constructiverealities/ProjectNorthStar/Mechanical/North Star 3D Files/components/leap-motion-classic.step

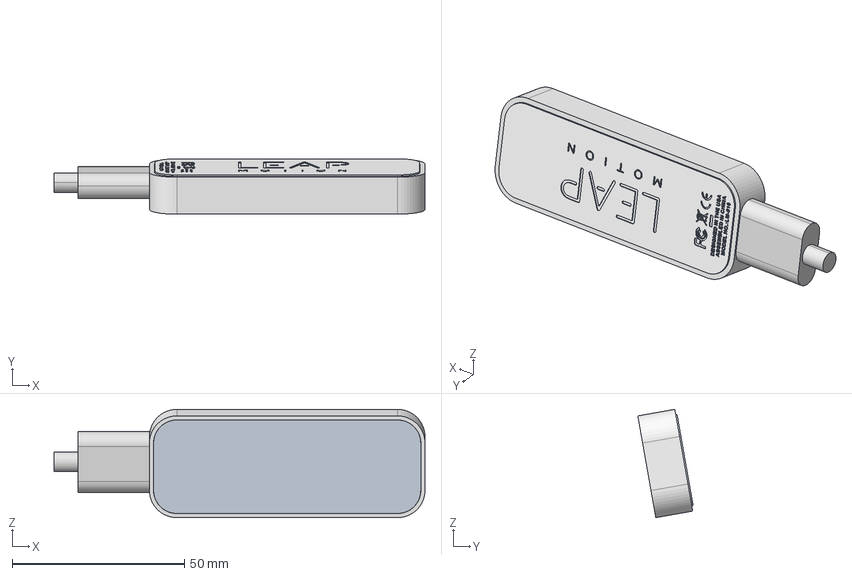
[picture p1: CAD file, 2018-08-21]
Mechanical/North Star 3D Files/components/leap-motion-classic.step
107.7 x 16.1 x 31.4 mm
TPU_DECO
TPU_ADHESIVE
MAIN_HOUSING
MAIN_LENS
HOUSING_FRAME
SUPPORT_RUBBER
SUPPORT_SPONGE
LED_LENS
CONDUCTIVE_SPONGE
LED_LENS_ADHESIVE
USB_SPONGE
CONDUCTIVE_FABRIC
USB Plug
