constructiverealities/ProjectNorthStar/Mechanical/North Star 3D Files/source/Optic Positions.step

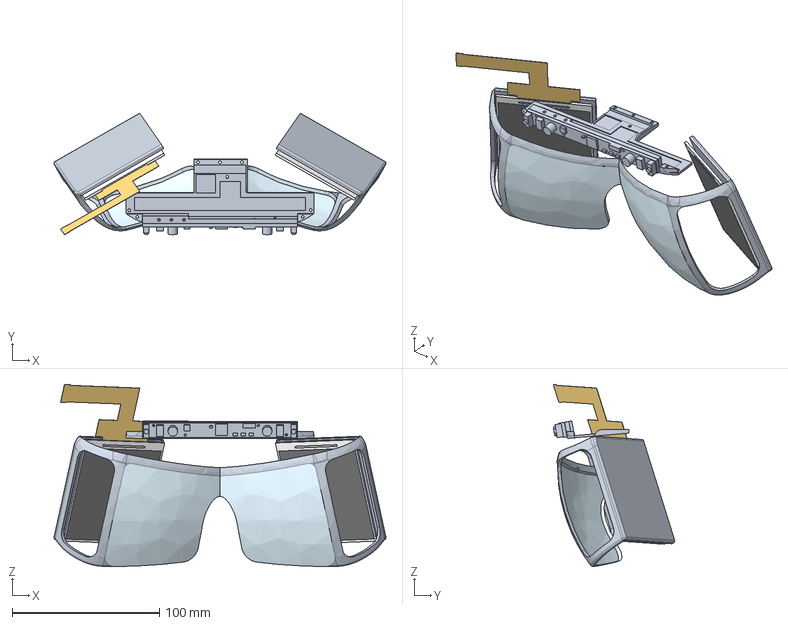
[picture p3: CAD file, 2018-08-01]
Mechanical/North Star 3D Files/source/Optic Positions.step
225.3 x 82.5 x 123.7 mm
Final Reflector
Rigel PCB Reference
VS033QHM-NW0 v1 x 4
