constructiverealities/ProjectNorthStar/Mechanical/North Star 3D Files/tooling/north-star-lens-vacuum-form-tool-proposal.stp

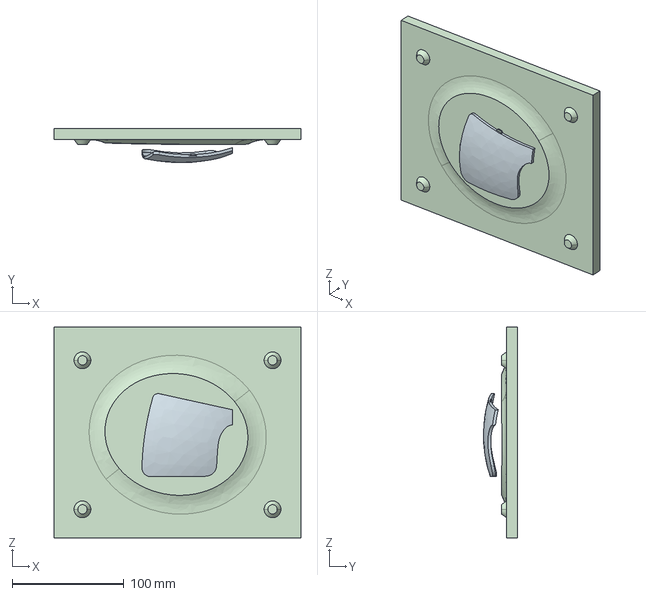
[picture p4: CAD file, 2018-08-21]
Mechanical/North Star 3D Files/tooling/north-star-lens-vacuum-form-tool-proposal.stp
220.6 x 30.5 x 188.1 mm
vacuum tool
lens
