constructiverealities/ProjectNorthStar/Mechanical/North Star 3D Files/components/leap-motion-rigel.step

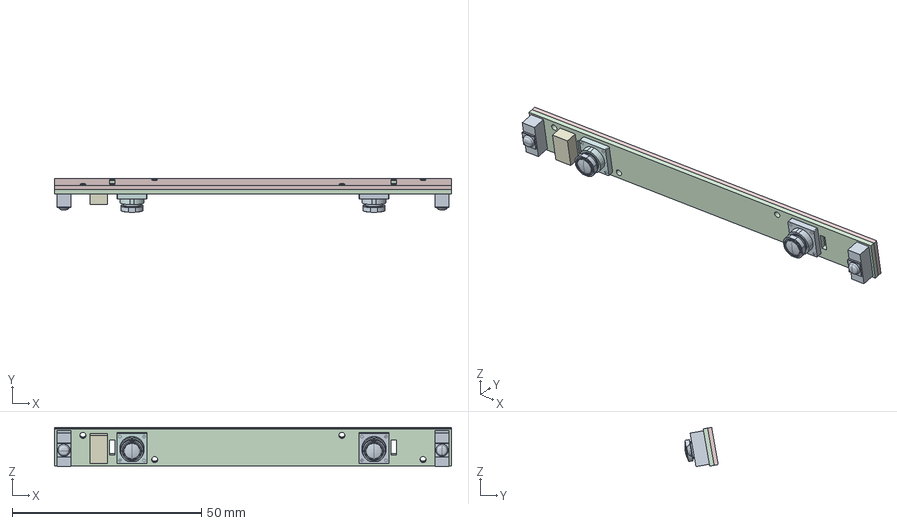
[picture p5: CAD file, 2018-08-21]
Mechanical/North Star 3D Files/components/leap-motion-rigel.step
105.0 x 8.87 x 10.4 mm
LCE_OPTICS_LV003A-0110-2-SOLID2
RIGEL_SINGLE_BOARD_PCB_RISER-2-
SFH_4716AS_20151008_GEOME-14375
SFH_4716AS_20151008_GEOME-17556
SFH_4716AS_20151008_GEOM-150207
BOARD-1-SOLID1
SFH_4716AS_20151008_GEOME-15558
C5-1_617207440-1_EXTRUDED_37-1-
RIGEL_SINGLE_BOARD_PCB_RISER-1-
LCE_OPTICS_LV003A-0110-1-SOLID2
BOARD-1-SOLID2
