constructiverealities/ProjectNorthStar/Mechanical/North Star 3D Files/source/Reflector Definition.step

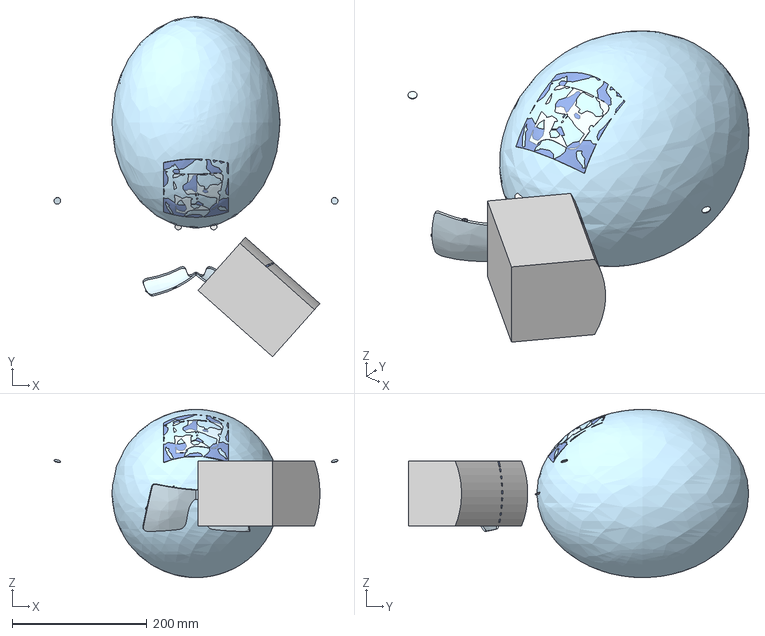
[picture p6: CAD file, 2018-08-01]
Mechanical/North Star 3D Files/source/Reflector Definition.step
422.1 x 506.0 x 250.0 mm
