constructiverealities/ProjectNorthStar/(commit log)

2018-08-01 move the source step files
    [Optic Positions.step, Reflector Definition.step]
2018-08-21 remove reference design 3d printing files
2018-08-21 addition of vacuum forming tool
    [north-star-lens-vacuum-form-tool-proposal.stp]
2018-08-21 breaking out components
    [leap-motion-classic.step, leap-motion-rigel.step]
2018-08-21 3d print project file for reference design
2018-08-21 single file with just the critical placements
    [key-placements.stp]
